markmenge/DogDoor_PlatformIO/README.md

This is an AI experiment. It is a work-in-progress. Check back later for when things start working.
