markmenge/DogDoor_PlatformIO/hardware/generated/bom_review.csv

Reference | Value | Footprint | Assembly | MPN | Populate
J1 | Heltec V2 LEFT | Connector_PinSocket_2.54mm:PinSocket_1x18_P2.54mm_Vertical | HAND | REVIEW_REQUIRED | True
J2 | Heltec V2 RIGHT | Connector_PinSocket_2.54mm:PinSocket_1x18_P2.54mm_Vertical | HAND | REVIEW_REQUIRED | True
J3 | 5V 3A CENTER POSITIVE | Connector_BarrelJack:BarrelJack_CUI_PJ-102AH_Horizontal | HAND | PJ-102AH | True
F1 | 3A fuse - inrush review | Fuse:Fuse_1206_3216Metric | SMD | 0467003.NR | True
D1 | SS34 controller isolation | Diode_SMD:D_SMA | SMD | SS34 | True
FB1 | Ferrite >=1A low DCR | Inductor_SMD:L_1206_3216Metric | SMD | REVIEW_REQUIRED | True
JP1 | REMOVE FOR USB POWER | Connector_PinHeader_2.54mm:PinHeader_1x02_P2.54mm_Vertical | HAND | REVIEW_REQUIRED | True
J4 | POWER ALT + GND | TerminalBlock_Phoenix:TerminalBlock_Phoenix_MKDS-1,5-2-5.08_1x02_P5.08mm_Horizontal | HAND | REVIEW_REQUIRED | True
C1 | 470uF 10V low ESR | Capacitor_THT:CP_Radial_D8.0mm_P3.50mm | HAND | REVIEW_REQUIRED | True
C2 | 470uF 10V low ESR | Capacitor_THT:CP_Radial_D8.0mm_P3.50mm | HAND | REVIEW_REQUIRED | True
C3 | 100nF 25V X7R | Capacitor_SMD:C_0805_2012Metric | SMD | REVIEW_REQUIRED | True
R1 | 10k 1% | Resistor_SMD:R_0805_2012Metric | SMD | REVIEW_REQUIRED | True
R2 | 10k 1% | Resistor_SMD:R_0805_2012Metric | SMD | REVIEW_REQUIRED | True
C4 | 100nF 25V X7R | Capacitor_SMD:C_0805_2012Metric | SMD | REVIEW_REQUIRED | True
J5 | NC STOP LOOP - OPEN DISABLES BOTH | Connector_PinHeader_2.54mm:PinHeader_1x02_P2.54mm_Vertical | HAND | REVIEW_REQUIRED | True
R3 | 100k | Resistor_SMD:R_0805_2012Metric | SMD | REVIEW_REQUIRED | True
R4 | 47k | Resistor_SMD:R_0805_2012Metric | SMD | REVIEW_REQUIRED | True
R5 | 47k | Resistor_SMD:R_0805_2012Metric | SMD | REVIEW_REQUIRED | True
R6 | 10k | Resistor_SMD:R_0805_2012Metric | SMD | REVIEW_REQUIRED | True
U1 | DRV8876PWPR | Package_SO:HTSSOP-16-1EP_4.4x5mm_P0.65mm_EP3.4x5mm_Mask2.46x2.31mm_ThermalVias | SMD | DRV8876PWPR | True
C10 | 22nF 25V X7R | Capacitor_SMD:C_0805_2012Metric | SMD | REVIEW_REQUIRED | True
C11 | 100nF 25V X7R | Capacitor_SMD:C_0805_2012Metric | SMD | REVIEW_REQUIRED | True
C12 | 100nF 25V X7R | Capacitor_SMD:C_0805_2012Metric | SMD | REVIEW_REQUIRED | True
C13 | 10uF 16V X7R | Capacitor_SMD:C_0805_2012Metric | SMD | REVIEW_REQUIRED | True
R10 | 1.50k 1% ~1A trip | Resistor_SMD:R_0805_2012Metric | SMD | REVIEW_REQUIRED | True
J6 | MOTOR A | TerminalBlock_Phoenix:TerminalBlock_Phoenix_MKDS-1,5-2-5.08_1x02_P5.08mm_Horizontal | HAND | REVIEW_REQUIRED | True
U2 | DRV8876PWPR | Package_SO:HTSSOP-16-1EP_4.4x5mm_P0.65mm_EP3.4x5mm_Mask2.46x2.31mm_ThermalVias | SMD | DRV8876PWPR | True
C20 | 22nF 25V X7R | Capacitor_SMD:C_0805_2012Metric | SMD | REVIEW_REQUIRED | True
C21 | 100nF 25V X7R | Capacitor_SMD:C_0805_2012Metric | SMD | REVIEW_REQUIRED | True
C22 | 100nF 25V X7R | Capacitor_SMD:C_0805_2012Metric | SMD | REVIEW_REQUIRED | True
C23 | 10uF 16V X7R | Capacitor_SMD:C_0805_2012Metric | SMD | REVIEW_REQUIRED | True
R20 | 1.50k 1% ~1A trip | Resistor_SMD:R_0805_2012Metric | SMD | REVIEW_REQUIRED | True
J7 | MOTOR B | TerminalBlock_Phoenix:TerminalBlock_Phoenix_MKDS-1,5-2-5.08_1x02_P5.08mm_Horizontal | HAND | REVIEW_REQUIRED | True
J8 | PIR IN 5V OUT GND | Connector_PinHeader_2.54mm:PinHeader_1x03_P2.54mm_Vertical | HAND | REVIEW_REQUIRED | True
R21 | 1k | Resistor_SMD:R_0805_2012Metric | SMD | REVIEW_REQUIRED | True
R23 | 100k | Resistor_SMD:R_0805_2012Metric | SMD | REVIEW_REQUIRED | True
C31 | 100nF 25V X7R | Capacitor_SMD:C_0805_2012Metric | SMD | REVIEW_REQUIRED | True
J9 | PIR OUT 5V OUT GND | Connector_PinHeader_2.54mm:PinHeader_1x03_P2.54mm_Vertical | HAND | REVIEW_REQUIRED | True
R22 | 1k | Resistor_SMD:R_0805_2012Metric | SMD | REVIEW_REQUIRED | True
R24 | 100k | Resistor_SMD:R_0805_2012Metric | SMD | REVIEW_REQUIRED | True
C32 | 100nF 25V X7R | Capacitor_SMD:C_0805_2012Metric | SMD | REVIEW_REQUIRED | True
J10 | OPEN REED SWITCH GND | Connector_PinHeader_2.54mm:PinHeader_1x02_P2.54mm_Vertical | HAND | REVIEW_REQUIRED | True
R31 | 1k | Resistor_SMD:R_0805_2012Metric | SMD | REVIEW_REQUIRED | True
C33 | 100nF 25V X7R | Capacitor_SMD:C_0805_2012Metric | SMD | REVIEW_REQUIRED | True
J11 | CLOSED REED SWITCH GND | Connector_PinHeader_2.54mm:PinHeader_1x02_P2.54mm_Vertical | HAND | REVIEW_REQUIRED | True
R32 | 1k | Resistor_SMD:R_0805_2012Metric | SMD | REVIEW_REQUIRED | True
C34 | 100nF 25V X7R | Capacitor_SMD:C_0805_2012Metric | SMD | REVIEW_REQUIRED | True
R40 | 0R LEGACY GPIO2 | Resistor_SMD:R_0805_2012Metric | SMD | REVIEW_REQUIRED | True
R41 | 0R ALT GPIO22 DNP | Resistor_SMD:R_0805_2012Metric | SMD | REVIEW_REQUIRED | False
R42 | 0R LEGACY GPIO12 | Resistor_SMD:R_0805_2012Metric | SMD | REVIEW_REQUIRED | True
R43 | 0R ALT GPIO27 DNP | Resistor_SMD:R_0805_2012Metric | SMD | REVIEW_REQUIRED | False
