markmenge/DogDoor_PlatformIO/hardware/BarrelJack_Horizontal.step

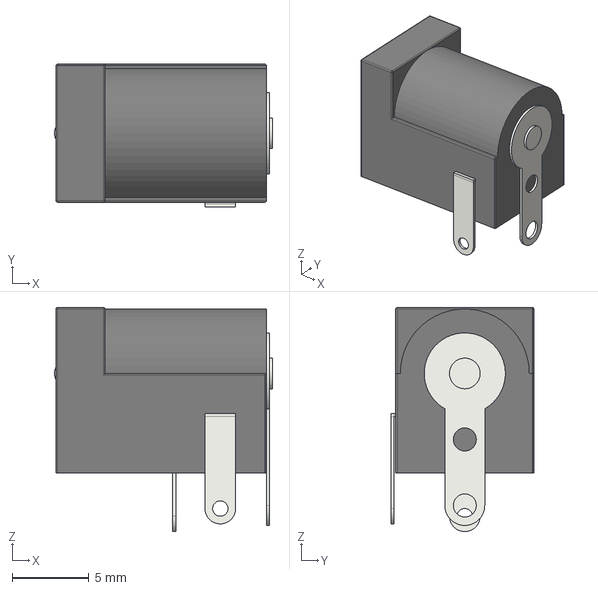
[picture p1: CAD file, 2026-10-12]
hardware/BarrelJack_Horizontal.step
14.2 x 9.30 x 14.6 mm
