markmenge/DogDoor_PlatformIO/hardware/generated/socket_fit_check.pdf

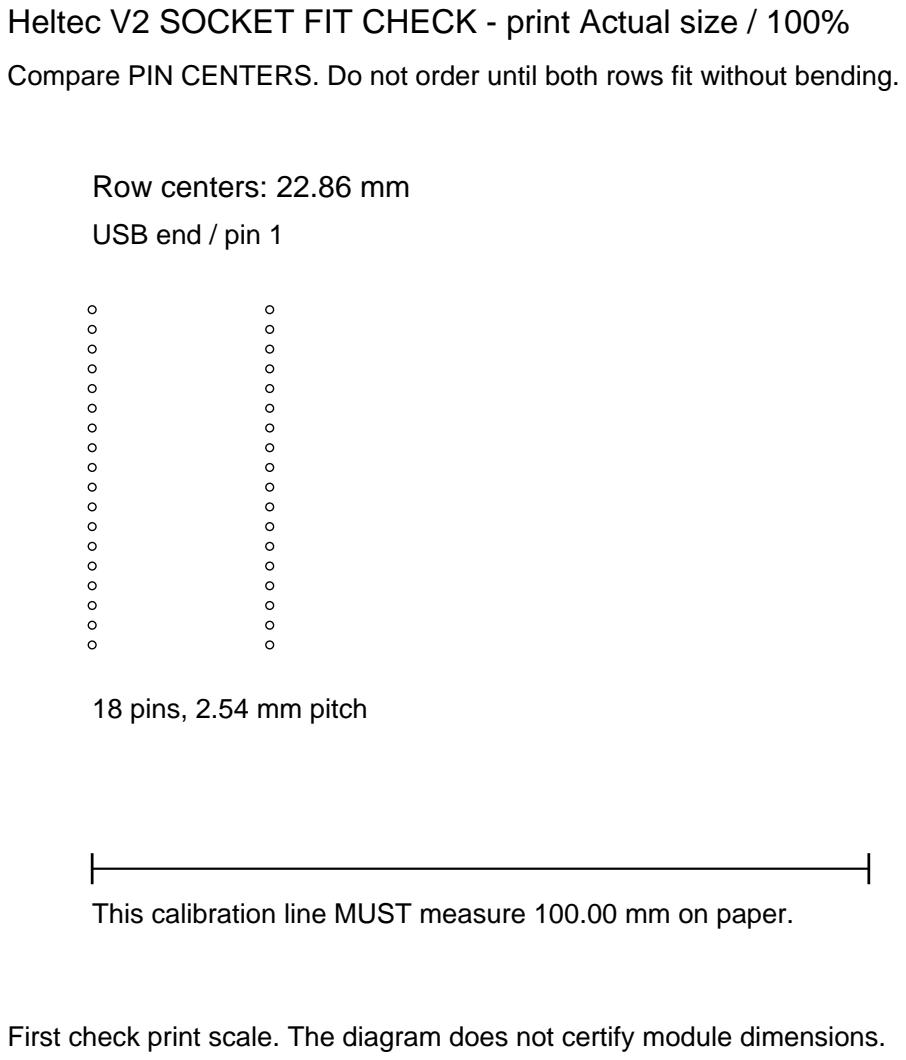
[picture p2: page 1]

Heltec V2 SOCKET FIT CHECK - print Actual size / 100%
Compare PIN CENTERS. Do not order until both rows fit without bending.

Row centers: 22.86 mm
USB end / pin 1

18 pins, 2.54 mm pitch

This calibration line MUST measure 100.00 mm on paper.

First check print scale. The diagram does not certify module dimensions.
