markmenge/DogDoor_PlatformIO/hardware/generated/dogdoor_review.kicad_pcb

## KiCad design hardware/generated/dogdoor_review.kicad_pcb (2026-10-12)

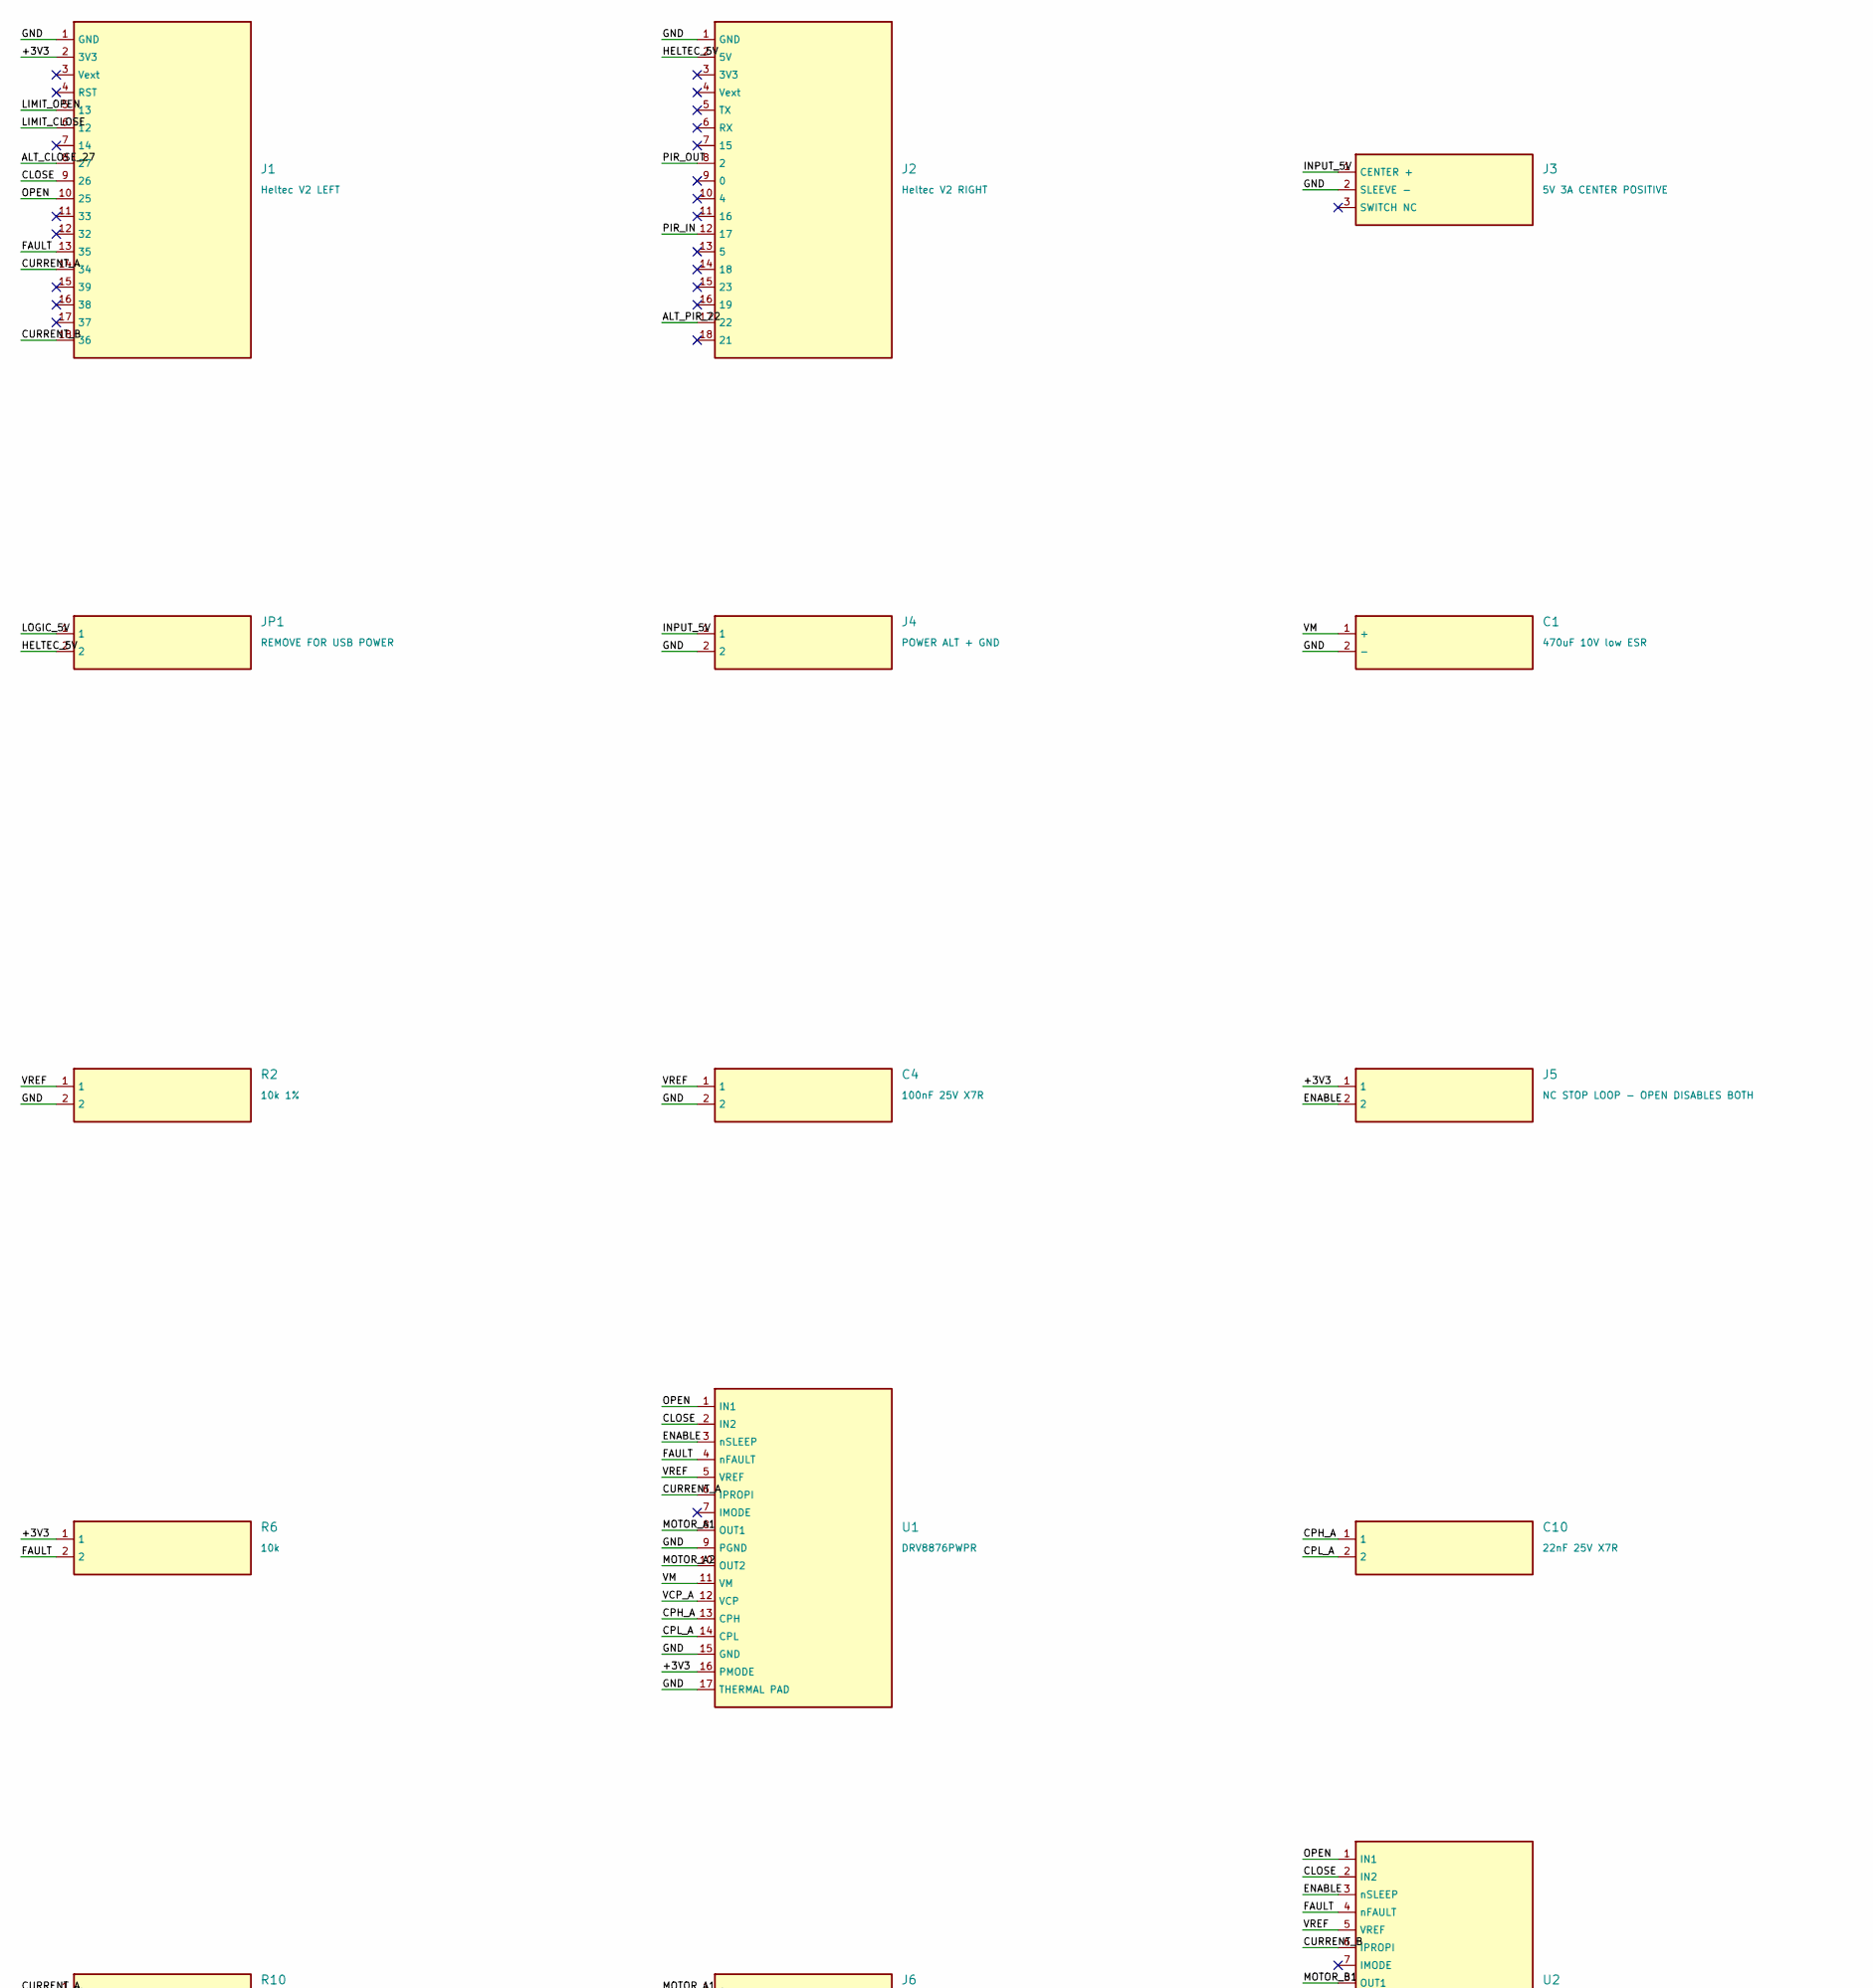
[picture p3: schematic dogdoor_review.kicad_sch, DogDoor REVIEW ONLY - not fabrication approved, part in row 1, column 1]

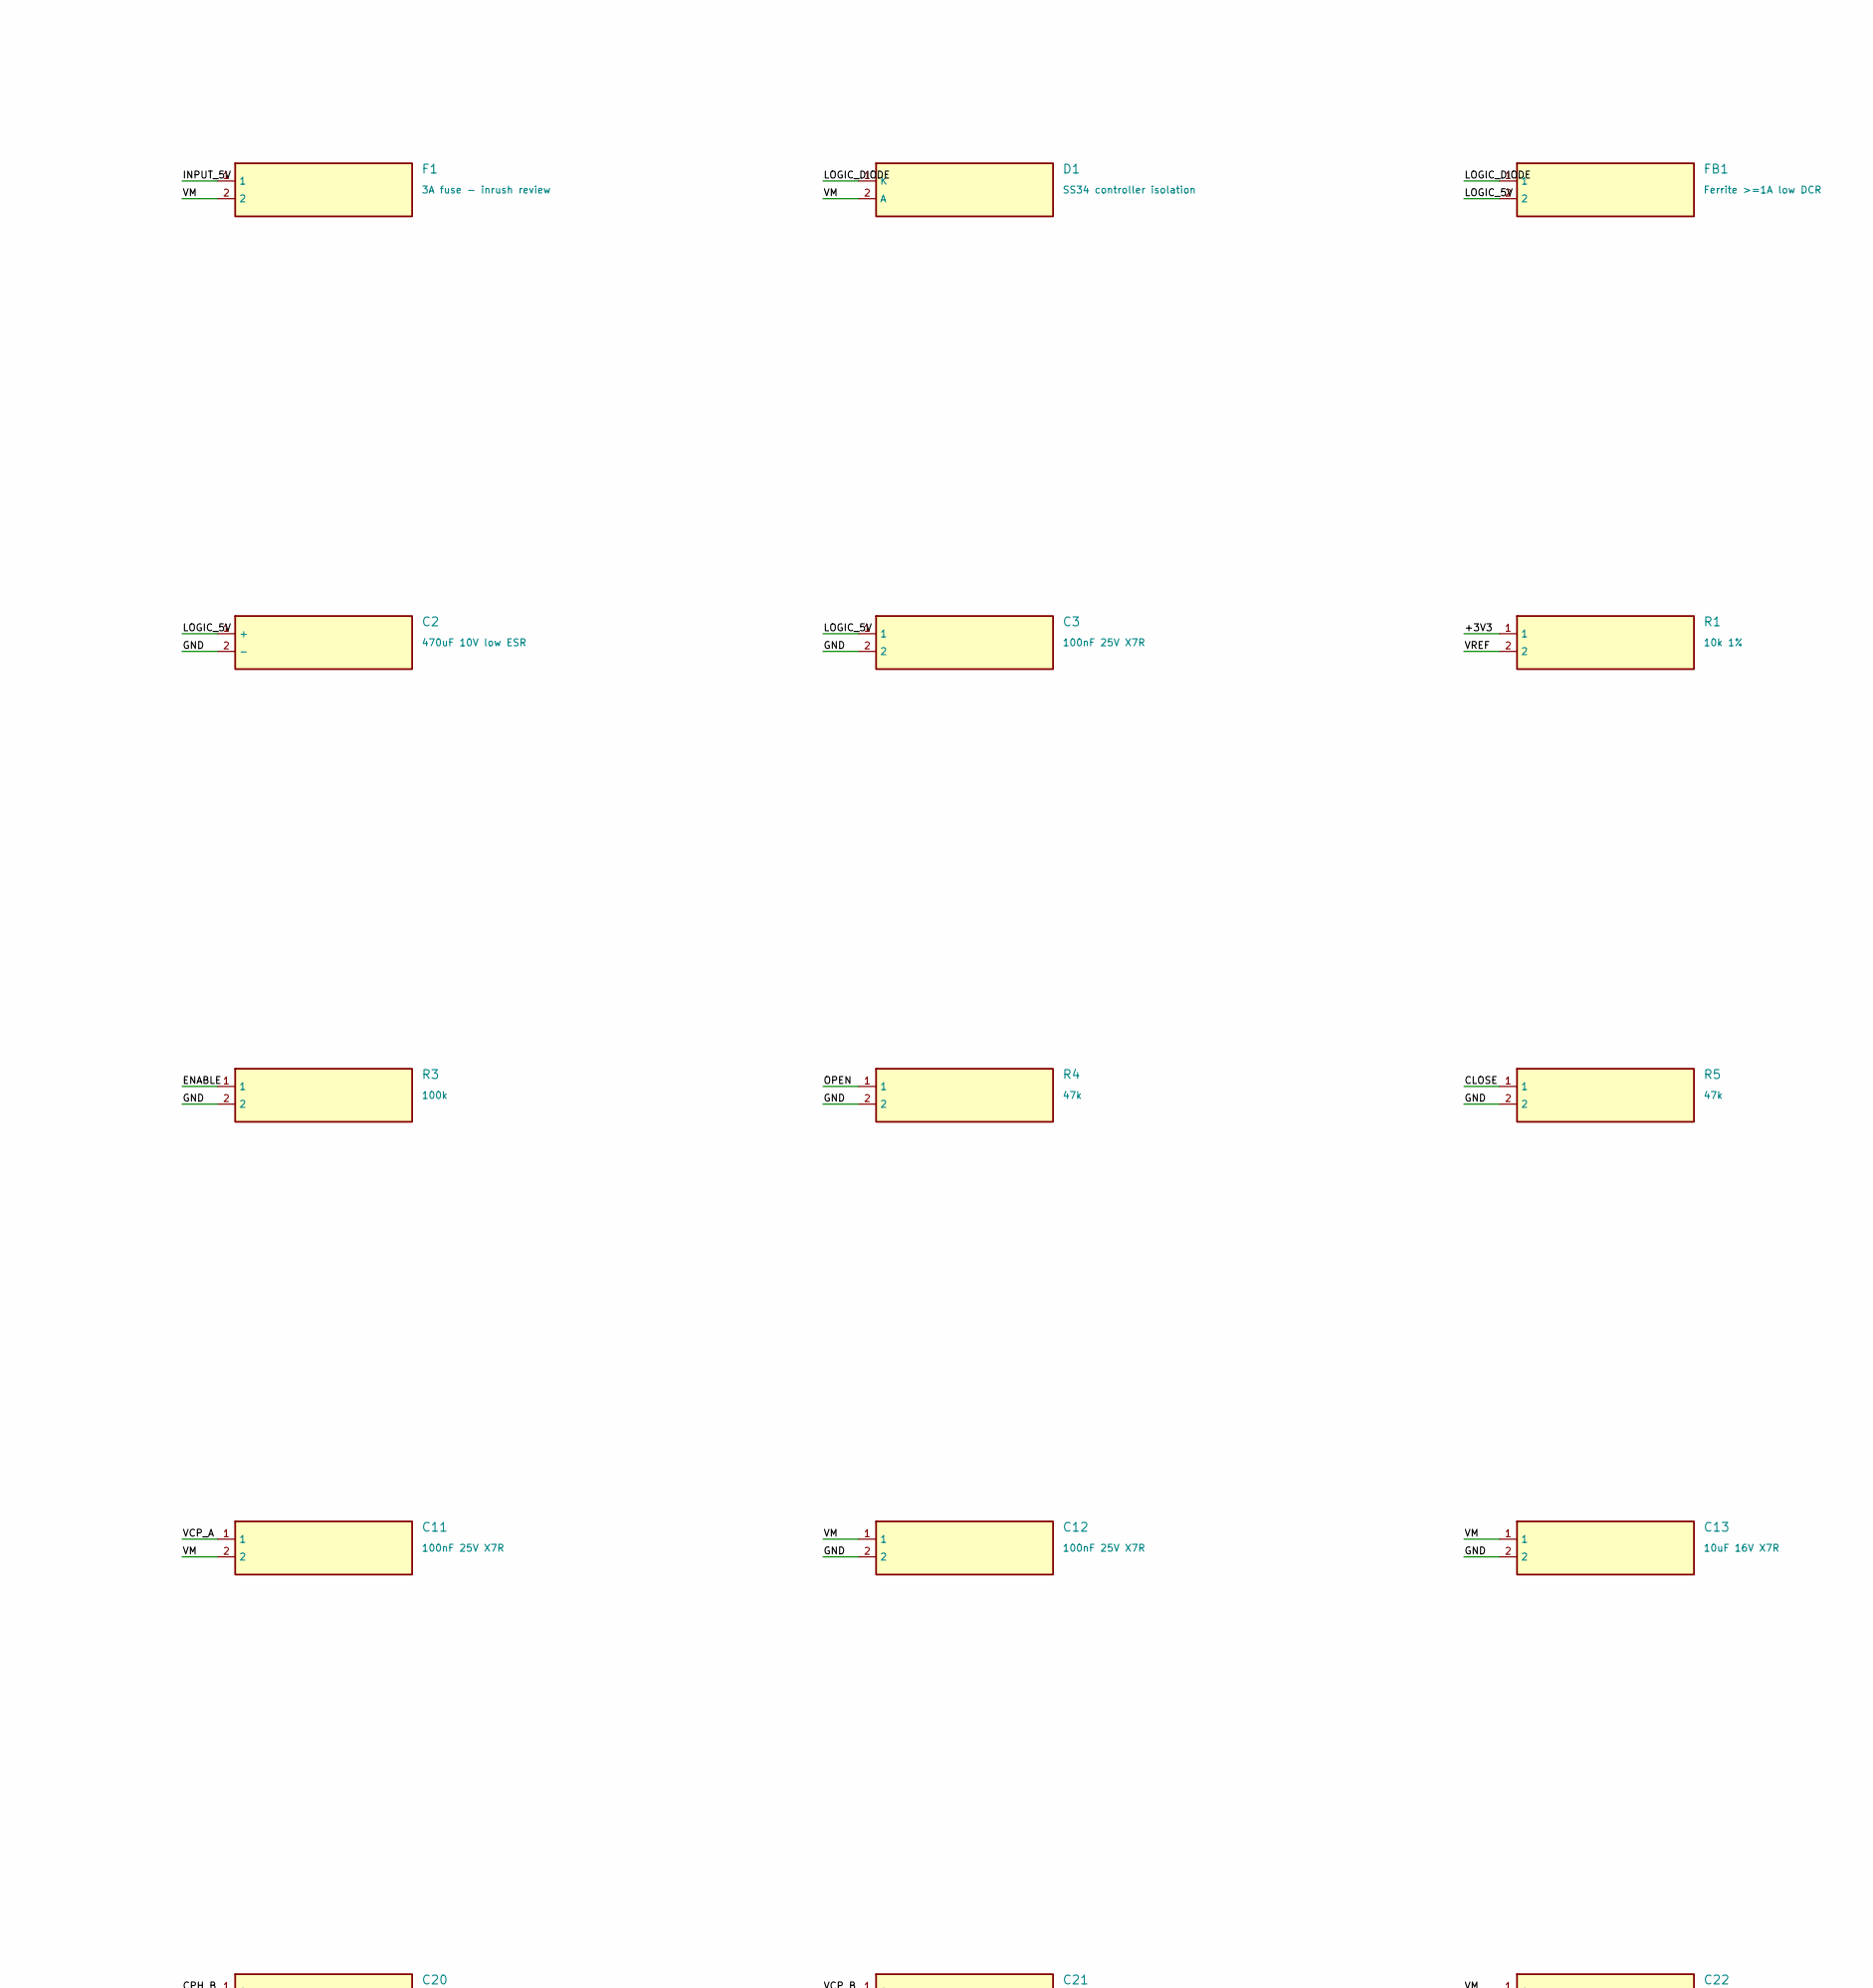
[picture p4: schematic dogdoor_review.kicad_sch, DogDoor REVIEW ONLY - not fabrication approved, part in row 1, column 2]

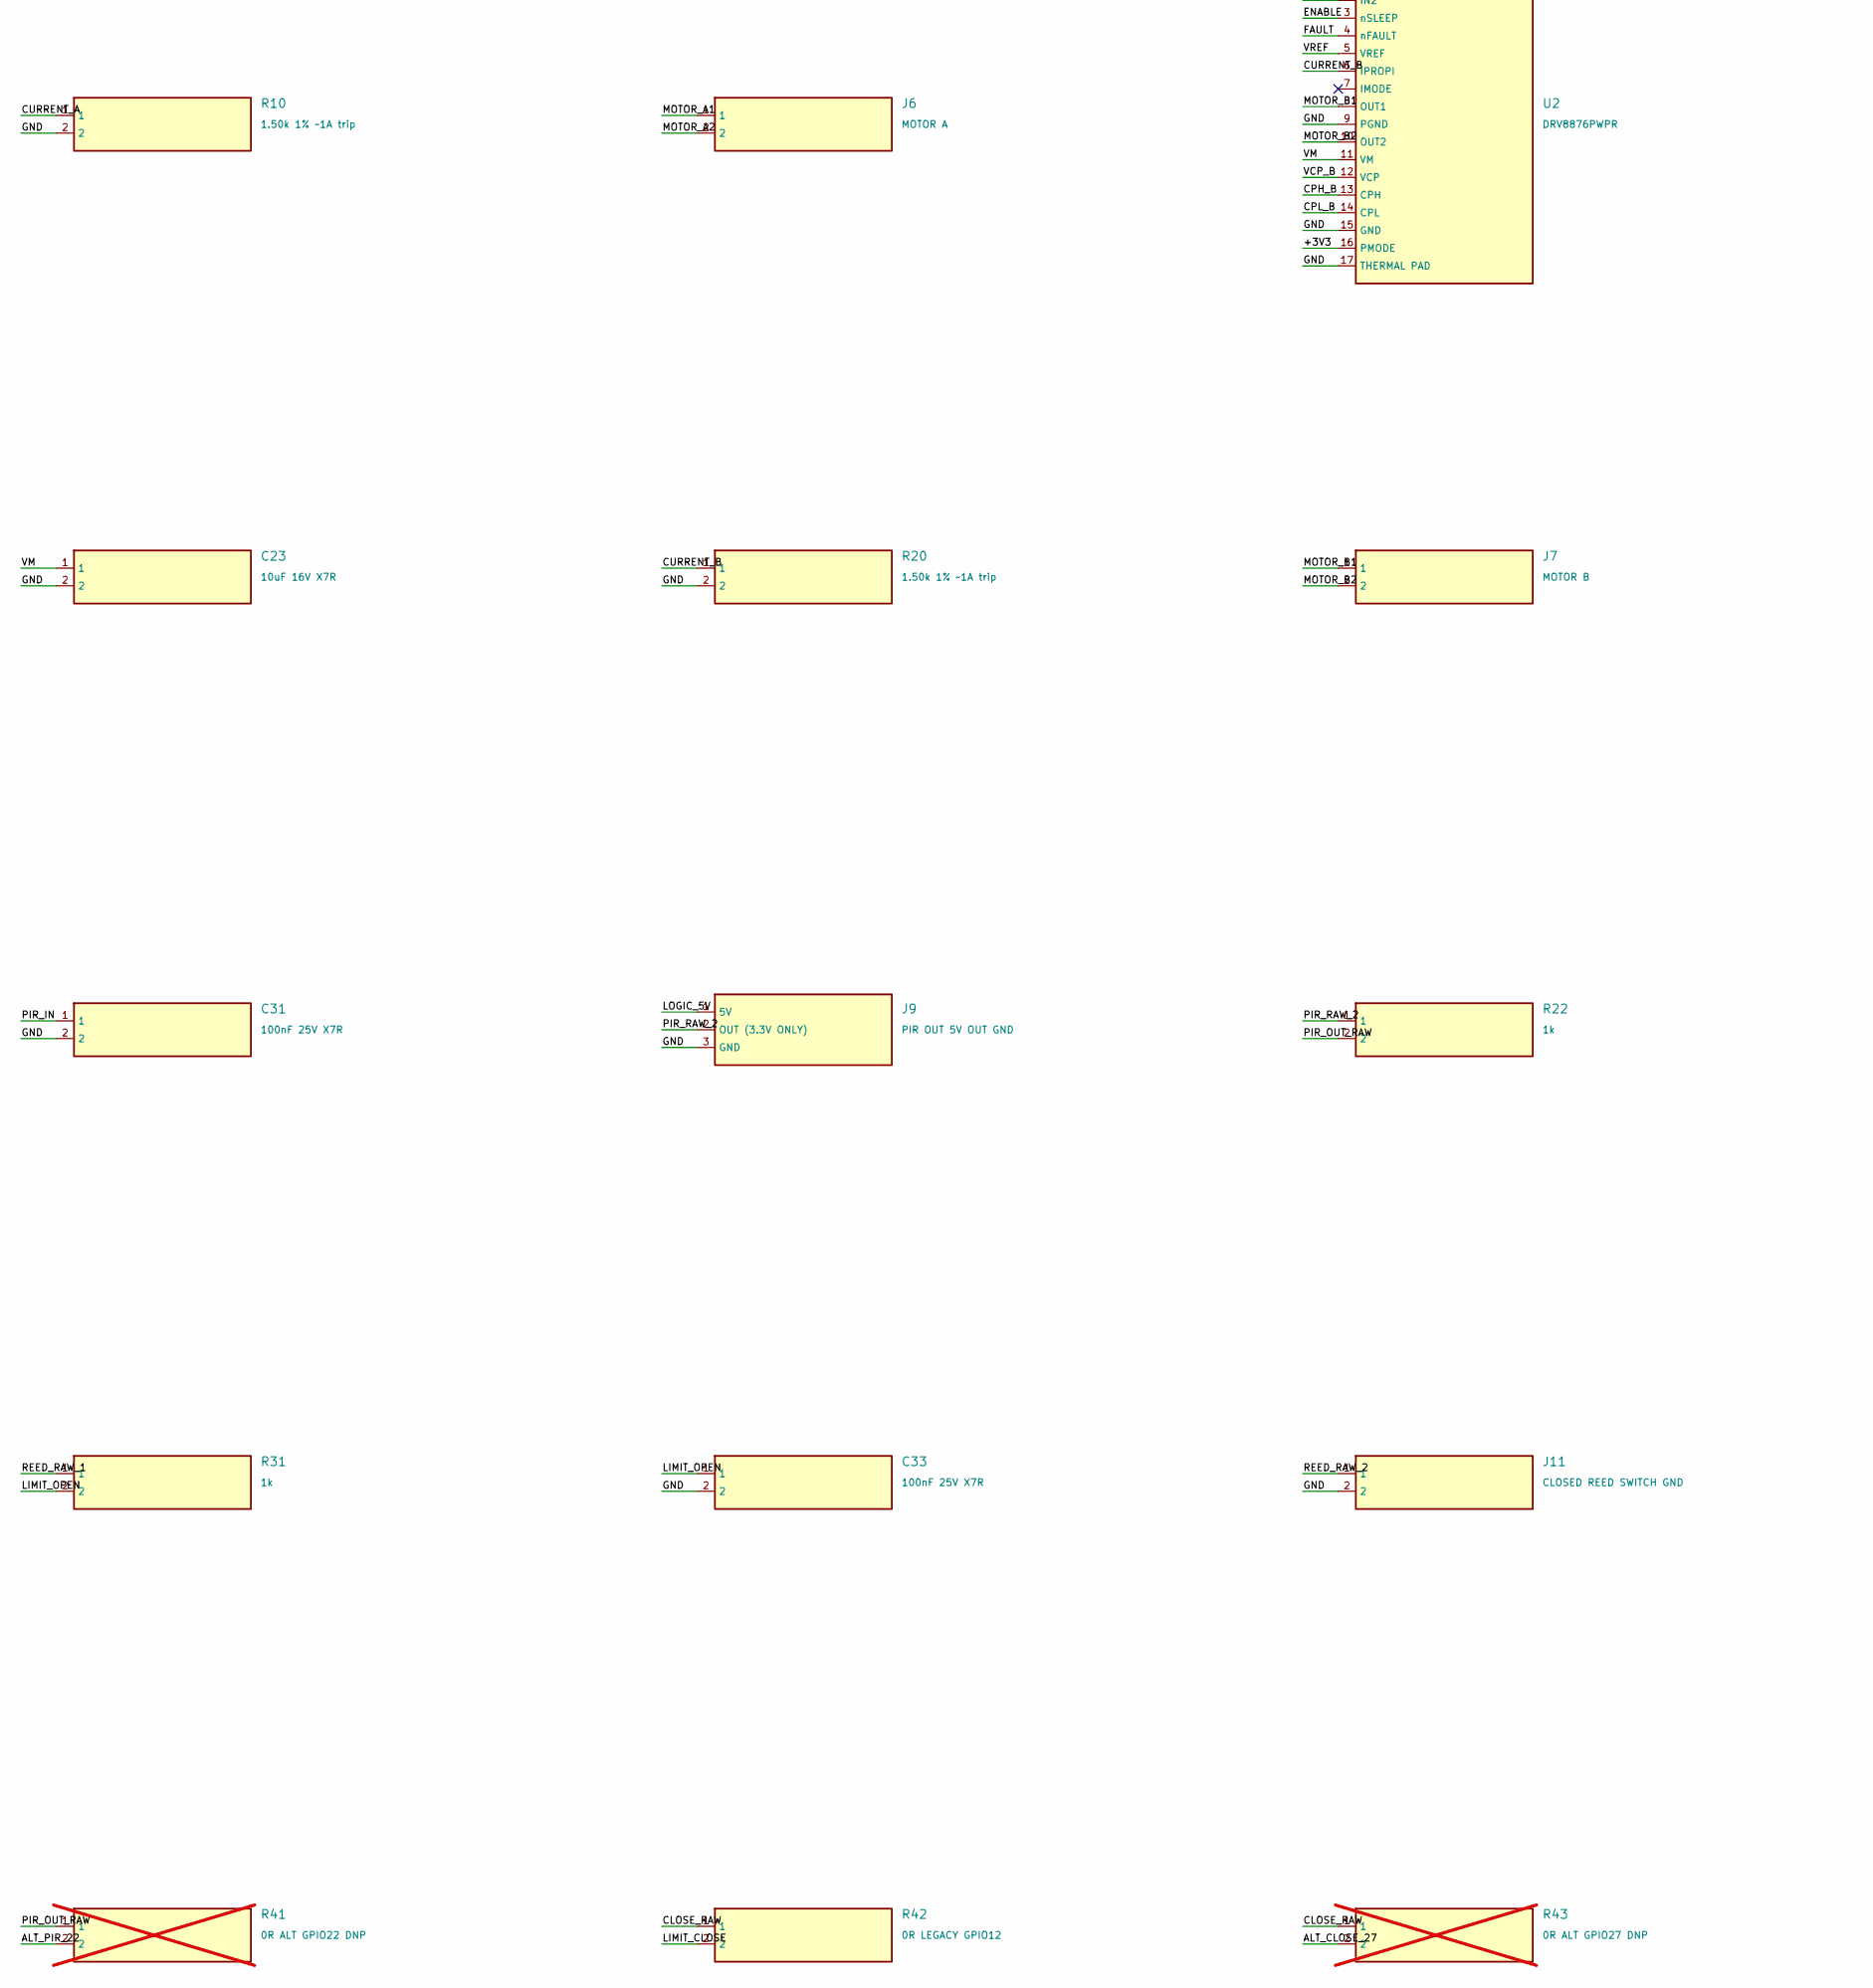
[picture p5: schematic dogdoor_review.kicad_sch, DogDoor REVIEW ONLY - not fabrication approved, part in row 2, column 1]

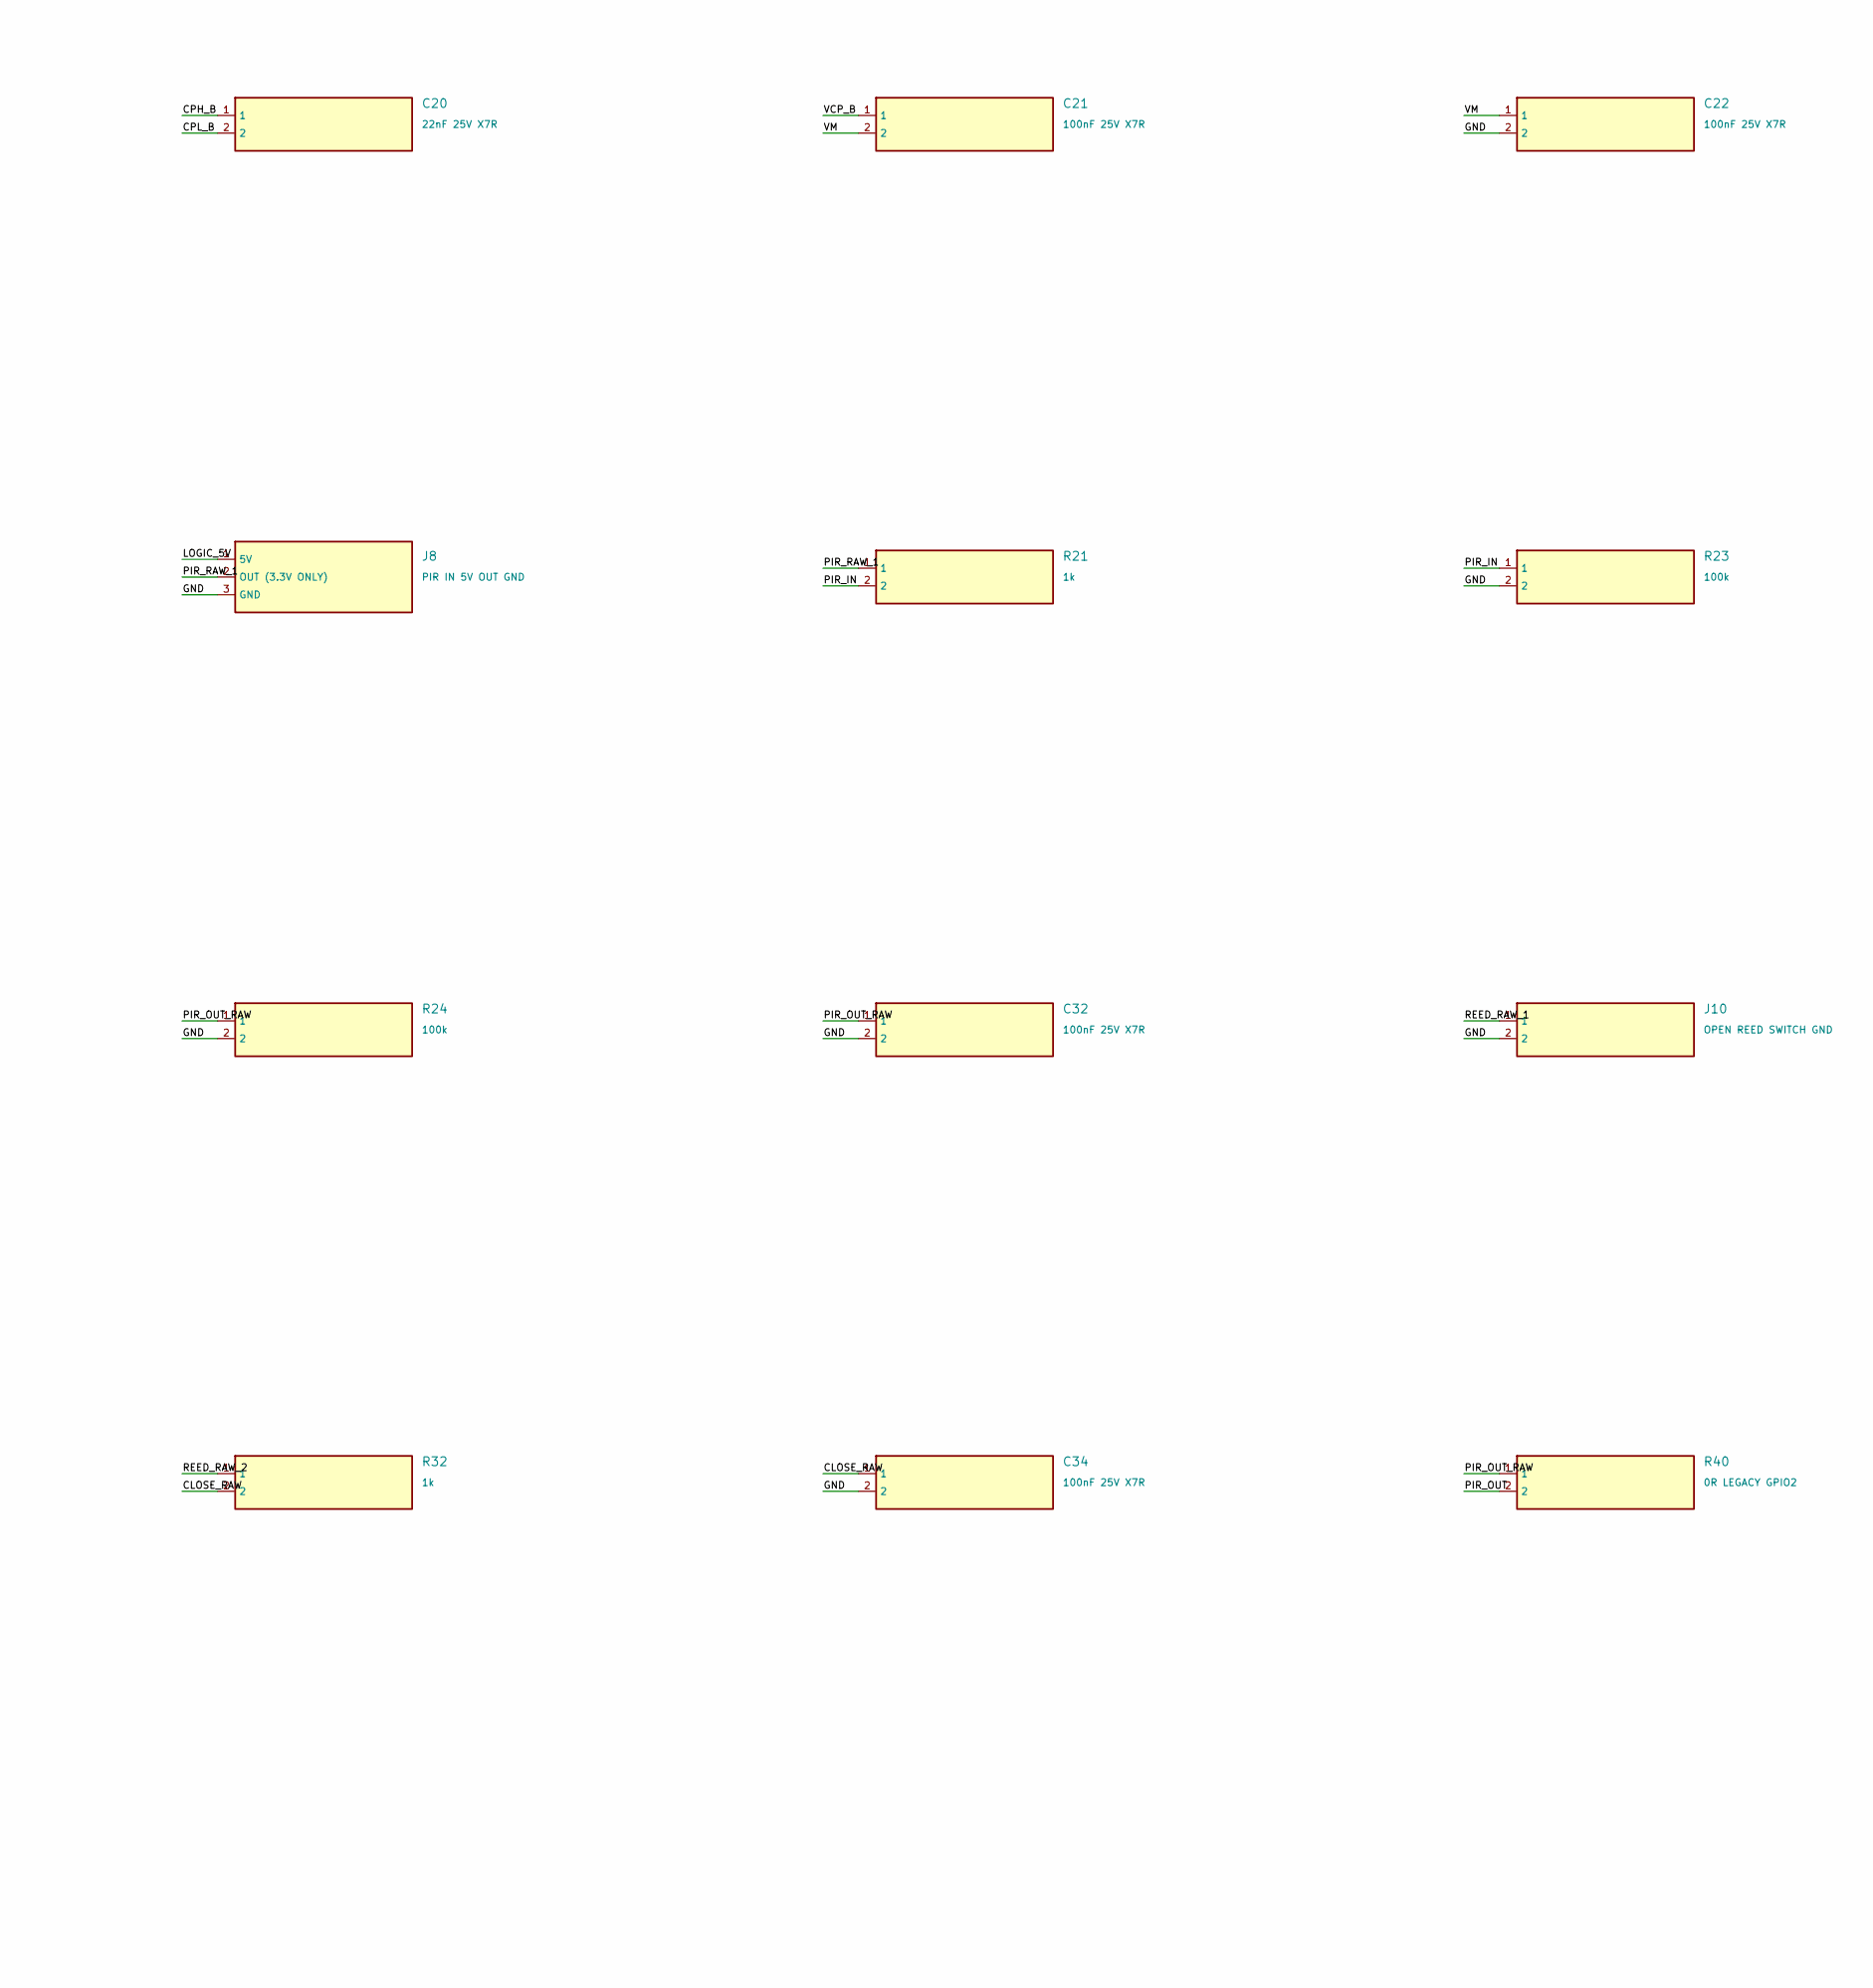
[picture p6: schematic dogdoor_review.kicad_sch, DogDoor REVIEW ONLY - not fabrication approved, part in row 2, column 2]

Parts:
C1, C2: 470uF 10V low ESR; CP_Radial_D8.0mm_P3.50mm
C3, C4, C11, C12, C21, C22, C31, C32, C33, C34: 100nF 25V X7R; C_0805_2012Metric
C10, C20: 22nF 25V X7R; C_0805_2012Metric
C13, C23: 10uF 16V X7R; C_0805_2012Metric
D1: SS34 controller isolation; D_SMA
F1: 3A fuse - inrush review; Fuse_1206_3216Metric
FB1: Ferrite >=1A low DCR; L_1206_3216Metric
J1: Heltec V2 LEFT; PinSocket_1x18_P2.54mm_Vertical
J2: Heltec V2 RIGHT; PinSocket_1x18_P2.54mm_Vertical
J3: 5V 3A CENTER POSITIVE; BarrelJack_CUI_PJ-102AH_Horizontal
J4: POWER ALT + GND; TerminalBlock_Phoenix_MKDS-1,5-2-5.08_1x02_P5.08mm_Horizont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
J5: NC STOP LOOP - OPEN DISABLES BOTH; PinHeader_1x02_P2.54mm_Vertical
J6: MOTOR A; TerminalBlock_Phoenix_MKDS-1,5-2-5.08_1x02_P5.08mm_Horizont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
J7: MOTOR B; TerminalBlock_Phoenix_MKDS-1,5-2-5.08_1x02_P5.08mm_Horizont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
J8: PIR IN 5V OUT GND; PinHeader_1x03_P2.54mm_Vertical
J9: PIR OUT 5V OUT GND; PinHeader_1x03_P2.54mm_Vertical
J10: OPEN REED SWITCH GND; PinHeader_1x02_P2.54mm_Vertical
J11: CLOSED REED SWITCH GND; PinHeader_1x02_P2.54mm_Vertical
JP1: REMOVE FOR USB POWER; PinHeader_1x02_P2.54mm_Vertical
R1, R2: 10k 1%; R_0805_2012Metric
R3, R23, R24: 100k; R_0805_2012Metric
R4, R5: 47k; R_0805_2012Metric
R6: 10k; R_0805_2012Metric
R10, R20: 1.50k 1% ~1A trip; R_0805_2012Metric
R21, R22, R31, R32: 1k; R_0805_2012Metric
R40: 0R LEGACY GPIO2; R_0805_2012Metric
R41: 0R ALT GPIO22 DNP; R_0805_2012Metric; not fitted
R42: 0R LEGACY GPIO12; R_0805_2012Metric
R43: 0R ALT GPIO27 DNP; R_0805_2012Metric; not fitted
U1, U2: DRV8876PWPR; HTSSOP-16-1EP_4.4x5mm_P0.65mm_EP3.4x5mm_Mask2.46x2.31mm_The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

Connections:
+3V3: J1.2 (3V3), J5.1, R1.1, R6.1, U1.16 (PMODE), U2.16 (PMODE)
ALT_CLOSE_27: J1.8 (27), R43.2
ALT_PIR_22: J2.17 (22), R41.2
CLOSE: J1.9 (26), R5.1, U1.2 (IN2), U2.2 (IN2)
CLOSE_RAW: C34.1, R32.2, R42.1, R43.1
CPH_A: C10.1, U1.13 (CPH)
CPH_B: C20.1, U2.13 (CPH)
CPL_A: C10.2, U1.14 (CPL)
CPL_B: C20.2, U2.14 (CPL)
CURRENT_A: J1.14 (34), R10.1, U1.6 (IPROPI)
CURRENT_B: J1.18 (36), R20.1, U2.6 (IPROPI)
ENABLE: J5.2, R3.1, U1.3 (nSLEEP), U2.3 (nSLEEP)
FAULT: J1.13 (35), R6.2, U1.4 (nFAULT), U2.4 (nFAULT)
GND: C1.2 (-), C2.2 (-), C3.2, C4.2, C12.2, C13.2, C22.2, C23.2, C31.2, C32.2, C33.2, C34.2, J1.1 (GND), J2.1 (GND), J3.2 (SLEEVE -), J4.2, J8.3 (GND), J9.3 (GND), J10.2, J11.2, R2.2, R3.2, R4.2, R5.2, R10.2, R20.2, R23.2, R24.2, U1.9 (PGND), U1.15 (GND), U1.17 (THERMAL PAD), U2.9 (PGND), U2.15 (GND), U2.17 (THERMAL PAD)
HELTEC_5V: J2.2 (5V), JP1.2
INPUT_5V: F1.1, J3.1 (CENTER +), J4.1
LIMIT_CLOSE: J1.6 (12), R42.2
LIMIT_OPEN: C33.1, J1.5 (13), R31.2
LOGIC_5V: C2.1 (+), C3.1, FB1.2, J8.1 (5V), J9.1 (5V), JP1.1
LOGIC_DIODE: D1.1 (K), FB1.1
MOTOR_A1: J6.1, U1.8 (OUT1)
MOTOR_A2: J6.2, U1.10 (OUT2)
MOTOR_B1: J7.1, U2.8 (OUT1)
MOTOR_B2: J7.2, U2.10 (OUT2)
OPEN: J1.10 (25), R4.1, U1.1 (IN1), U2.1 (IN1)
PIR_IN: C31.1, J2.12 (17), R21.2, R23.1
PIR_OUT: J2.8 (2), R40.2
PIR_OUT_RAW: C32.1, R22.2, R24.1, R40.1, R41.1
PIR_RAW_1: J8.2 (OUT (3.3V ONLY)), R21.1
PIR_RAW_2: J9.2 (OUT (3.3V ONLY)), R22.1
REED_RAW_1: J10.1, R31.1
REED_RAW_2: J11.1, R32.1
VCP_A: C11.1, U1.12 (VCP)
VCP_B: C21.1, U2.12 (VCP)
VM: C1.1 (+), C11.2, C12.1, C13.1, C21.2, C22.1, C23.1, D1.2 (A), F1.2, U1.11 (VM), U2.11 (VM)
VREF: C4.1, R1.2, R2.1, U1.5 (VREF), U2.5 (VREF)

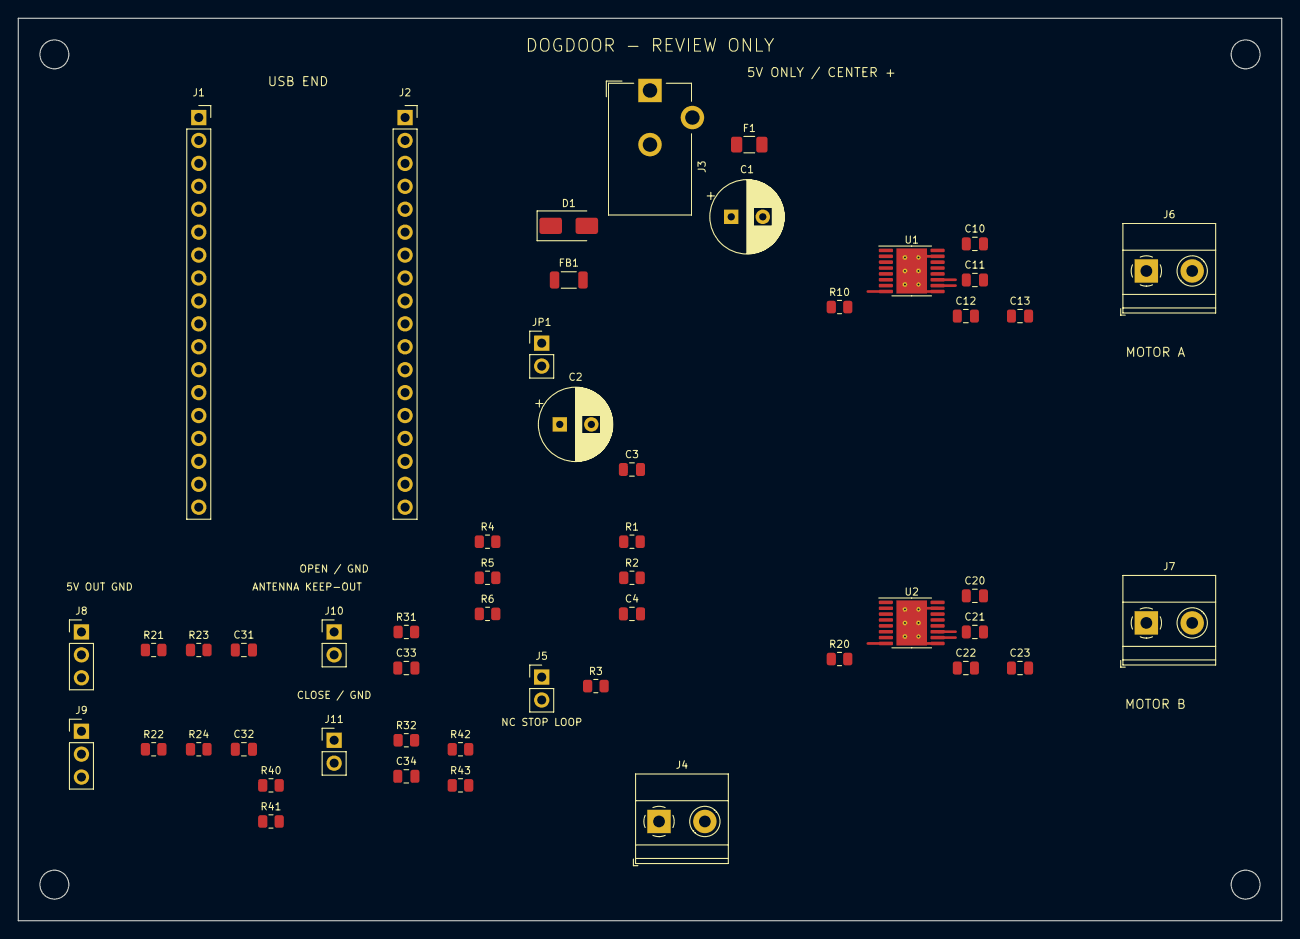
[picture p7: board dogdoor_review.kicad_pcb from above]

Board: 2 copper layers, 140.0 x 100.0 mm, 55 parts (0 on the bottom side), 36 nets.

Other parts of the board:
H1, H2, H3, H4: MountingHole_3.2mm_M3
