markmenge/DogDoor_PlatformIO/(commit log)

2026-10-12 Add PlatformIO firmware and reviewed DogDoor PCB project
    [bom_review.csv, dogdoor_review.kicad_pcb, dogdoor_review.kicad_sch, dogdoor_review_routed.kicad_pcb, placement_review.csv]
2026-10-12 Add carrier 3D assembly models and save routed board in KiCad 10
    [BarrelJack_Horizontal.step, dogdoor_review.kicad_pcb, dogdoor_review_routed.kicad_pcb]
